PhilParisi/PondAutomation/README.md

# PondAutomation
A collaboration for the development of an automated algae pond. This github repository serves as both the knowledge base of the system as well as the code backend. 

Each github 'branch' represents a different version of the project. Use the dropdown above to see/use different branches of the code.

## Quick Start
0. setup RPi
1. update crontab (see below instructions), update reboot_pond.py
1. `git clone https://github.com/PhilParisi/PondAutomation`
2. `tmux`
3. `python3 automate_pond.py --config configs/your_config.py`

### File Structure
`PondAutomation/`
|`configs/` contains configurations needed to run the system  
| `data/` upon running the script, outputs are stored here  
| |---- `DATETIME/`  
| | |---- `pond_settings_used.csv` contains the configurations used  
| | |---- `DATETIME_sensor_data` contains sensor measurements (future work)  
| `functions/` contains the scripts that run on the raspberry pi for operation (not to be run by user)
| `graphics/` contains diagrams and photos, some of which are used in this guide  
| `automate_pond.py` is the single script that needs to be run by the user, it controls the entire pond
| `material_list.xlsx` lists the items needed to build the system  
| `reboot_pond.py` is used for automatically running the RPi after a power outage (not to be run by user), it calls the automate_pond.py function  
| `run_on_reboot.sh` is called by the RPi's crontab @reboot, which then calls the reboot_pond.py function (this must be set as an excecutable `chmod +x run_on_reboot.sh`)  

### System Requirements
The following describes the platform the code runs on, other configurations have not been tested
- RaspberryPi 4B
- python3

Python Libraries
- standard libraries (already accessible with `import`)
- RPi.GPIO library, which should come pre-installed on standard Raspbian OS systems

### Accessing the Code
If you are new to git and plan to use its features, you should see this [beginner guide](https://medium.com/@PhilParisi/getting-started-with-github-for-people-who-hate-github-1f25b071930d) (amongst others). 

If you plan to edit code and contribute to this project, you should clone the repository with  
`git clone https://github.com/PhilParisi/PondAutomation`. You can also email the developer and request to be a Contributor. 

If you simply want a local copy of the code to play around with, you can either clone (like above) or click the green `Code` button and `Download ZIP` to your local system.

# Versions

## V0 - Flow Control & Inception
Goal: develop a simple control loop system to open/close solenoid for adding water to the algae pond.  

This version of the code (found on the `v0-field` branch) can be run using `python3 automate_pond.py` and responding to prompts in the terminal.

## V1 - Power Outages & Updates
Goal: V1 builds on V0 by making the system automatically restart after power outages.   

*Major Change #1: launching*
The launch command has changed to `python3 automate_pond.py --config configs/your_config_here.py`. You now need to specify a configuration file when launching (example config files are available in the `/config` folder of the repository, such as `quick.py`). You can edit that config, or create a new with a different name. 

*Major Change #2: auto restart*
This allows the autopond program to continue where things left off before a power outage. The re-launch procedure happens automatically upon powering on of the RPi by reading from a `outage.csv` file that is updates every time there is a 'heartbeat' in the program. To enable the autorestart, be sure to include the relevant parameter `'pond_autorestart_after_outage':1` in your `/config/your_config.py` file. 

To trigger the restart, you need to do the following (one time):
- clone the v1-field repository
14. (new for v1) update your crontab:
- `crontab -e`
- scroll to the bottom, and add the below line:
- `@reboot /home/DEVICE_USERNAME/PondAutomation/run_on_reboot.sh` (update based on your device's username, then hit ctrl+o, enter, ctrl+x)
15. (new for v1) open `reboot_pond.py` and update the filepath as well to `/home/DEVICE_USERNAME/PondAutomation/...` for the path to the CSV file

Now, everytime the RPi is powered up... if the `'pond_autorestart_after_outage':1` in the config and if there was a `/config/outage.csv` file present on boot, the pond with automatically pick up where things left off.

To STOP the pond for automatically restarting, you need to SSH into the RPi, attach to the tmux session where the autopond script is running, and use ctrl+c to kill the script. Then, delete the `/configs/outage.csv` file too. Now upon reboot, the RPi will not do anything. You could also go back into `crontab -e` and comment out the line that runs the .sh script on reboot.

## Usage
Full usage of the code can be found later in this guide. 

## Schematic
The below schematic shows the wiring of electrical components and application.
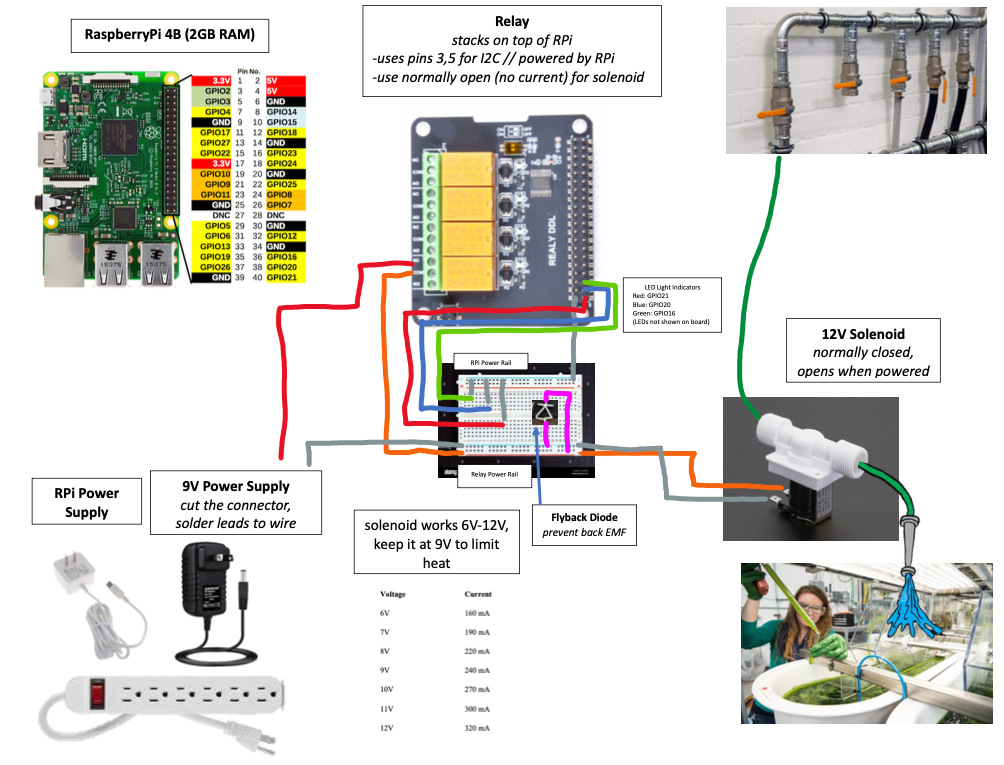
[picture p1: graphics/pond_schematic.png]
Pond Schematic


#### Key Hardware
1. RaspberryPi 4B (2GB RAM) for control
2. Relay to power solenoid
3. Solenoid (6-12V) to open/shutoff flow
4. Breadboard w/ Diode and LED state indicator lights (see 'State Transition Diagram' below)

## Operation and Failure Modes

### Light Indicators
There are three lights in the box that are used to communicate to people what's happening:
- Green --> 'drought' state. No water flows as solenoid is shut. Everything is ok.
- Blue --> 'flood' state. Water is flowing as solenoid is open. Everything is ok.
- Red --> 'error' state. You shouldn't be in this state. Something is wrong and it's probably not evident. Try SSH'ing into the RPi, use tmux to get into the terminal, look at and note the recent messages, kill it (ctrl+c) and restart the pond. If that doesn't work, contact the programmer. 

### Failure
The solenoid is **normally closed**, which means:
  - If you need to stop the flow, simply unplug everything (power it down) and the solenoid will close, stopping flow.
  - If there is 'no flow' and you want flow, power on the system and run the scripts. If nothing is working, contact the programmer or remove the solenoid manually to ensure flow.

### Inputs
Before running the script, the user must create (or edit an existing) configuration .py file to store key settings that determine behavior of the system
1. `minutes_till_first_flood` How many MINUTES until the first flood? --> the system starts with no flow, then will start flowing after this duration
2. `flood_duration` What is the FLOOD duration in MINUTES? --> how long the solenoid will stay open (free flow) for during floods
3. `drought_duration` What is the DROUGHT duration in MINUTES? --> how long the solenoid will stay closed (no flow) for during droughts
4. `total_program_runtime` How many MINUTES do you want to run the program for? --> for the number that is inputted, the program ends when this duration is reached // if 0 is inputted, there will be no programmed end to the program (note: if a power outage hits, the program will pick up where it left off and continue running until the duration is reached)
5. `pond_autorestart_after_outage` Would you like to automatically start the pond after outages? --> if 1, the script automatically restarts when power cycled // if 0, the script will die when powered down and must be manually restarted  

Note: the configuration files must be in the form provided in `quick.py` and be inside the `configs/` folder. 

### Outputs
- the solenoid is programmed to open and close at intervals set in the 'Inputs' section
- data is written to .csv files in the `/data` folder (not yet fully implemented)
- a `configs/outage.csv` is created that is used for restarting the script after outages

## State Transition Diagram
Below is the state transition diagram which describes the behavior of the system, and how the program transitions to different states. This is also called the 'control flow'.  
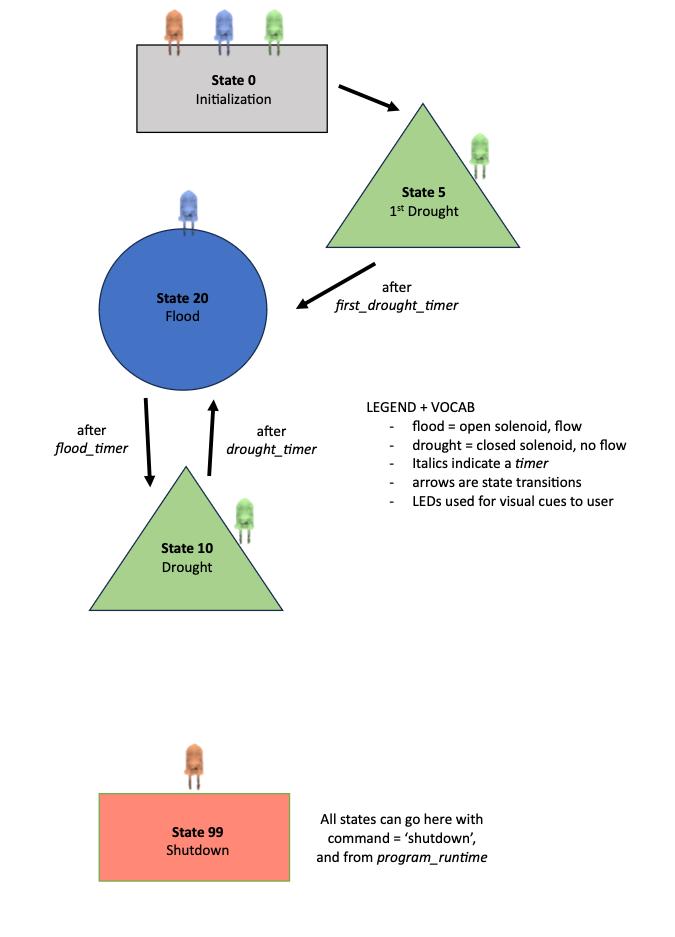
[picture p2: graphics/pond_statetransition.png]
state transition diagram


## Working with your RaspberryPi

### Setting up your RaspberryPi (first time)
In this section, we cover the basics of setting up a raspberryPi device. For this, you will need the physical computer with a monitor, keyboard, and mouse.

1. insert the microSD card into the slot on the underside of the panel
2. plug in peripherals (monitor, keyboard, mouse), no power yet
3. power on the RPi (important that the monitor is plugged in before powering on)
4. follow instructions to setup the device like you would a normal computer (treat RPi like a normal computer fyi, and remember the username/password that you set!)
5. set the hostname of your device by opening a terminal (CTRL + ALT + T), typing `sudo raspi-config`, go to 'system options', go to 'hostname' and type the hostname you want. close the terminal
6. enable ssh (secure shell connectivity), by opening a terminal (CTRL + ALT + T), typing `sudo raspi-config`, enter, go to 'interface options', go to 'SSH' and switch to 'yes'. close the terminal
7. reboot the system by opening a terminal and typing `sudo reboot 0`, enter
8. log back into your RPi
9. connect to the internet (either by ethernet cable, or via WiFi)
10. clone this repository to your *home directory* by opening a terminal (CTRL + ALT + T) and typing `cd`, enter, `git clone https://github.com/PhilParisi/PondAutomation`, enter. *you must clone this repo to your home directory!*
11. different versions of the code are available on different _branches_, type `git fetch --all` to get all branches locally
12. switch to the branch you want with `git checkout branch_you_want`
13. (new for v1) ensure the `run_on_reboot.sh` file is set as an excecutable by running `chmod +x ~/PondAutomation/run_on_reboot.sh`
14. (new for v1) update your crontab:
- `crontab -e`
- scroll to the bottom, and add the below line:
- `@reboot /home/DEVICE_USERNAME/PondAutomation/run_on_reboot.sh` (update based on your device's username, then hit ctrl+o, enter, ctrl+x)
15. (new for v1) open `reboot_pond.py` and update the filepath as well to `/home/DEVICE_USERNAME/PondAutomation/...` for the path to the CSV file
15. Once your physical system and electronics are wired up, you cant test the lights and the solenoid with:
- `python3 ~/PondAutomation/test_lights.py` the output of your script should match the lights that are blinking
- `python3 ~/PondAutomation/test_solenoid.py` the output of your script should match whether the solenoid is open/closed. Note that some solenoids won't fully open (no visual cue) and require flow pressure in order to open (try blowing air through) 
16. once your RPi is all setup, the lights and solenoid are working, you should be good to go! see the 'Running Scripts' section of this guide

### Remote Connections to your RaspberryPi
If you want to run scripts like you are using a regular computer with a monitor, keyboard, and mouse directly attached to the RPi, skip to 'Running Scripts'.  
If your RPi is stashed somewhere and you want to connect remotely, keep reading.  

We can connect to the pi over WiFi (internet not required) or via an Ethernet cable. WiFi is recommended and tends to more reliable with corporate computer systems.

#### WiFi
1. connect the pi to a wifi network (you should have already done this in 'Setting up your RPi'), connect your personal computer to the same network
2. MAC and Linux --> open a terminal and `ssh username@hostname` or `ssh username@ip_address` and you should be in!
3. Windows --> I recommend downloading [Bitvise SSH](https://www.bitvise.com/ssh-client-download) program, launch it, then type in the details into the GUI (in the top right), and you should be in!

#### Ethernet
1. connect an ethernet cable between your pi and your personal computer (this forms a direct connection)
2. make sure your computer and RPi are disconnected from other networks
3. use `ifconfig` on the RPi to see its network connections

## Working on the RPi (Running Scripts, Checking on the Pond)

#### SSH Into the RPi
Assuming you have the code on the pi and everything is physically setup according to the schematic...
1. Connect to the RPi (SSH in from either terminal (Mac/Linux) or Bitvise (Windows))
2. Once you ssh in, you will be in a terminal for the RPi (see 'Terminal Commands' section in this guide if you are new to using a terminal)
3. Navigate into the project folder that contains this code, likely `cd PondAutomation` (you can also run `ls` to see the files/folders in your current directory)

#### Start the Pond (new for v1)
- copy the `configs/quick.py` config, then update the input parameters according to your needs (save it as `my_params.py` or whatever you choose)
- *VERY IMPORTANT*, start a tmux session with `tmux`
- Launch the automation file with `python3 automate_pond.py --config configs/my_params.py` (replace my_params.py with the actual config you want)
- Program should run!
- CTRL+b (together), then d (after), and this will detach you from the tmux session allowing the script to continue running even when you disconnect from the SSH session
- If close to the RPi system, check the lights and confirm everything is functioning as expected
- Close the terminal and move on with your life

#### Shutdown the Pond
- From the terminal, find the name of the tmux session that's running with `tmux list-sessions`. The first word before the colon is your 'session_name' (it's likely pond_reboot, 0, 1, or 2)
- `tmux attach-session -t session_name` to get into that session. This should take you to viewing the outputs from the automate_pond.py script, you should see timestamps, heartbeats, and other status messages.
- To kill the script (and shutdown the pond), CTRL+C
- Then you can close the terminal if you have nothing else to do!

#### Checking in on Operational Pond
- From the terminal, find the name of the tmux session that's running with `tmux list-sessions`. The first word before the colon is your 'session_name' (it's likely pond_reboot, 0, 1, or 2)
- `tmux attach-session -t session_name` to get into that session. This should take you to viewing the outputs from the automate_pond.py script, you should see timestamps, heartbeats, and other status messages.
- Observe the messages and understand what's going on.
- To leave the pond running and exit the tmux session, CTRL+b (together), then d (after), and you will detach from the tmux session. Pond will continue running.

#### Other (non-autopond) Scripts
As requested by users, there are a few extra features that have been developed outside of the autopond functionality.  

A few notes:
- these can be run inside or outside of a tmux window, it doesn't matter.   
- what does matter, is that you kill the autopond script before running the below (see section 'Shutdown the Pond').  
- these scripts runs once and finish, unlike the autopond script that continually runs.   

1. close the solenoid only (stop flow)  
- `python3 close_solenoid.py`  
- note that in emergencies, you can close the solenoid by unplugging the entire system  
- this script turns off the solneoid (closing it, preventing flow) and turns on the green light (indicate a drought)  
- the system will stay like this indefinitely  
- from here you can run any other scripts, such as open_solenoid.py or automate_pond.py  
  
2. open the solenoid only (allow flow)  
- `python3 open_solenoid.py`  
- this script turns on the soelnoid (opening it, allowing flow) and turns on the blue light (indicate a flood)  
- the system will stay like this indefinitely  
- from here you should run close_solenoid.py to stop thef low, then you can run automate_pond.py to start the autopond  

## Useful Commands for the RPi

### Terminal Commands
These are commands you can run from the command line right after SSH'ing into the RPi
- `ls` will _list_ the contents of the current folder you are in
- `cd folder_name` will _change directory_ into the folder with the name 'folder_name' (note, it has to be visible when you run `ls`)
  - ex: `cd PondAutomation`
- `cd ..` moves you 'up' one directory (gets out of the current directory)
- `python3 script_name.py` uses python to run a python script
  - ex: `python3 automate_pond.py` or `python3 test_lights.py`
- `ssh username@ip_address` will ssh another device

### Tmux Commands
tmux is a terminal management system. It allows us to 'detach' from a terminal. Once we SSH into the RPi, we want the ability to launch a script _and detach_ from the terminal so we can break the SSH connection, go about our day, and let the script continue to run.
- `tmux` or `tmux new-session -s session_name` will start a new tmux session. If the pond is not running, you need to start a new session, then run the automate_pond.py script
- `tmux list-sessions` shows the current sessions. If the pond is currently running, this will show you the current session name
- `tmux attach-session -t session_name` will attach your terminal to the existing tmux session. Do this when the pond is running and you want to attach to it
- `tmux kill-session -t session_name` will destroy a tmux session. Do this when you accidentally made a tmux session and need to get rid of it. You can always start a new one!
- `tmux new-session -d -s session_name 'python3 automate_pond.py --configs configs/your_config.py'` starts a tmux session with a name, run the python file within that session, and immediately detaches from it
