PhilParisi/PondAutomation/material_list.xlsx

Sheet: BOM
DISCOVERY Pond Automation Project
This form details the bill of materials needed for creation of an autopond monitoring system.
No backup parts are included, you are encouraged to order spares
Component | Qty | Per Unit Cost | Total Line Item Cost | Vendor | Link (feel free to search elsewhere) | Notes
RaspberryPi Parts
RasperryPi 4B (2GB) | 1 | $45.00 | $45.00 | DigiKey | https://www.digikey.com/en/products/detail/raspberry-pi/SC0193-9/10258782 | can opt for more RAM such as 4GB or 8GB if desired
RPi SD card 16GB w/ adapter | 1 | $9.28 | $9.28 | DigiKey | https://www.digikey.com/en/products/detail/raspberry-pi/SC0252K/13548616
RPi SD Card 64GB | 1 | $14.10 | $14.10 | DigiKey | https://www.digikey.com/en/products/detail/raspberry-pi/SC0339L/12339165
RPi hdmi converter | 1 | $3.50 | $3.50 | DigiKey | https://www.digikey.com/en/products/detail/raspberry-pi/SC0224/10258772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
HDMI cable | 1 | $8.78 | $8.78 | DigiKey | https://www.digikey.com/en/products/detail/tripp-lite/P569-001/6204983
RPi power supply | 1 | $8.00 | $8.00 | DigiKey | https://www.digikey.com/en/products/detail/raspberry-pi/SC0445/10258760
RPi fan | 1 | $3.50 | $3.50 | DigiKey | https://www.digikey.com/en/products/detail/adafruit-industries-llc/3368/6680553
also need a mouse, keyboard, and monitor w/ HDMI input
Solenoid Parts
Solenoid (normally closed) | 1 | $6.95 | $6.95 | DigiKey | https://www.digikey.com/en/products/detail/adafruit-industries-llc/997/6827136
Solenoid power cable | 1 | $10.73 | $10.73 | DigiKey | https://www.digikey.com/en/products/detail/cui-inc/SWI6-9-N-P5/5415074
DockerPi Relay | 1 | $18.99 | $18.99 | DigiKey | https://www.digikey.com/en/products/detail/seeed-technology-co-ltd/111100001/10290290
adaptors for 1/2" male threads on the solenoid to connect with your piping system, pipe tape, hose clamps
Circuits & Wiring
breadboard for jumpers | 1 | $2.90 | $2.90 | DigiKey | https://www.digikey.com/en/products/detail/dfrobot/FIT0096/7597069
solder boards | 1 | $1.48 | $1.48 | DigiKey | https://www.digikey.com/en/products/detail/digi-key-electronics/DKS-SOLDERBREAD-02/15970925
MF jumper cables pack | 1 | $2.10 | $2.10 | DigiKey | https://www.digikey.com/en/products/detail/sparkfun-electronics/PRT-12794/5993859
MM jumper cables pack | 1 | $2.10 | $2.10 | DigiKey | https://www.digikey.com/en/products/detail/sparkfun-electronics/PRT-12795/5993860
FF jumper cables pack | 1 | $2.10 | $2.10 | DigiKey | https://www.digikey.com/en/products/detail/sparkfun-electronics/PRT-12796/5993861
Green LED | 1 | $0.97 | $0.97 | DigiKey | https://www.digikey.com/en/products/detail/sunled/XLM2DG12W/4745831
Red LED | 1 | $0.73 | $0.51 | DigiKey | https://www.digikey.com/en/products/detail/sunled/XLM2CRK14W/4901607
Blue LED | 1 | $0.52 | $0.64 | DigiKey | https://www.digikey.com/en/products/detail/sunled/XLFBB12W/4745819
resistors (3), diodes (1), electrical tape, solder + soldering iron, multimeter, wire cutter/strippers, heat shrink + heat gun
Housing (optional depending on your design requirements)
Velcro Tape | 1 | $9.99 | $9.99 | Amazon | https://www.amazon.com/Strips-Adhesive-Strong-Crafting-Organization/dp/B0BTM8CWTS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
Tupperware (housing) | 1 | $13.72 | $13.72 | Amazon | https://www.amazon.com/Sistema-Storage-Container-Leftovers-Dishwasher/dp/B00284AG5U
Power strip (2 plugs minimum)
Ethernet cable
right angle PVC w/ Connector to make 'snorkel' for wires
 |  | TOTAL COST | $165.34

Sheet: Order 2
DISCOVERY Pond Automation Project
Order 2
Component | Qty | Per Unit Cost | Total Line Item Cost | Ordered? | Vendor | Link (feel free to search elsewhere)
DockerPi Relay | 1 | $18.99 | $18.99 |  | DigiKey | https://www.digikey.com/en/products/detail/seeed-technology-co-ltd/111100001/10290290
Cat6a passthrough | 1 | $11.98 | $11.98 |  | DigiKey | https://www.digikey.com/en/products/detail/stewart-connector/SS-60400-030/16053009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
short ethernet (in box) | 1 | $3.19 | $3.19 |  | DigiKey | https://www.digikey.com/en/products/detail/tripp-lite/N201-06N-BL/7696152
electrical tape | 1 | $1.64 | $1.64 |  | DigiKey | https://www.digikey.com/en/products/detail/panduit-corp/ST14-075-60BK/13678936
PVC adaptor (1/2" hose ID to 1/2" NPT female thread) | 1 | $9.97 | $9.97 |  | Amazon | Tefen Nylon 66 Hose Fitting, Adapter, Gray, 1/2" Hose ID x 1/2" NPT Female (Pack of 10) - 12256708083
Pipe thread tape | 1 | $2.19 | $2.19 |  | Amazon | https://www.amazon.com/Dixon-Valve-TTB75-Industrial-Temperature/dp/B003D7K8E0
1/4" x 25ft electrical conduit | 1 | $18.99 | $18.99 |  | Amazon | https://www.amazon.com/MGI-SpeedWare-Corrugated-High-Temperature-Automotive/dp/B0B4X73GRN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
 |  |  |  |  |  | ^ MGI SpeedWare Corrugated Non-Split Conduit, Black Wire Tubing for High-Temperature Automotive Harness and Indoor Outdoor Wire Management - 25ft Length (Inner Diameter 1/4")
 |  | TOTAL COST | $66.95

Sheet: Supplies we have
don’t order anything here, this is a list of things we already have
zip ties
spare tubing
heat shrink w/ heat gun
cutting equipment
wire strippers/cutter
diodes
resistor
jumper wires?
extension cord
solder and soldering iron

Sheet: Maybe later
don't order these, just nice part to know are around for quick reference if we need them
RPi Case | 1 | $3.62 | $3.62 | https://www.digikey.com/en/products/detail/raspberry-pi/SC0193-9/10258782
long ethernet (shielded, lab space) | 1 | $9.79 | $9.79 | Digikey | https://www.digikey.com/en/products/detail/tripp-lite/N125-007-GY/4438412
Right Angle PVC piping | 2 | $4.41 | $8.82 | McMasterCarr | 4880K775 (https://www.mcmaster.com/4880K775)
These are the LASCO plastic fittings that I think should do well https://www.lascofittings.com/products/1435005
