PhilParisi/PondAutomation/(commit log)

2023-11-17 first working code (no hardware), control loop functioning as expected
    [pond_settings_used.csv]
2023-11-22 added gitignore, fixed inf bug, removed data from data/
    [pond_settings_used.csv]
2023-11-22 removed data from data/, added .gitignore
    [pond_settings_used.csv]
2023-11-22 removed inf bug, added ignore, remove data from data/
    [pond_settings_used.csv]
2023-12-01 added solenoid test script, integrated into main script, and preliminary testing looks like everything is working as expected
2023-12-07 updated print_w_time() function, added heartbeat functionality for terminal outputs
2023-12-08 added bill of materials
    [material_list.xlsx]
2024-01-04 field fixes with py packages
    [pond_functions.py]
2024-01-04 testing with print()
2024-01-04 print test
2024-01-04 new f string in reboot
    [reboot_pond.py]
2024-01-04 found issues in the timer reset call when resetting outage
    [5on_5off_indefinite.py, pond_functions.py, reboot_pond.py]
2024-01-05 timer updates
2024-01-05 updated timers to re-enter the state correctly with time
    [automate_pond.py, pond_functions.py]
2024-01-06 schematic updates, gitignore updates
